GadgetReboot/Serial_UPDI/README.md

# Serial_UPDI
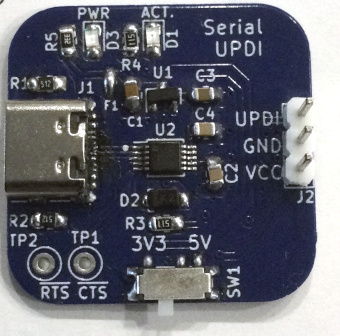
[picture p1: Assembled_PCB.jpg]
PCB
<br><br><BR><BR>
Serial UPDI Programmer
