GadgetReboot/Serial_UPDI/Sch_Serial_UPDI.pdf

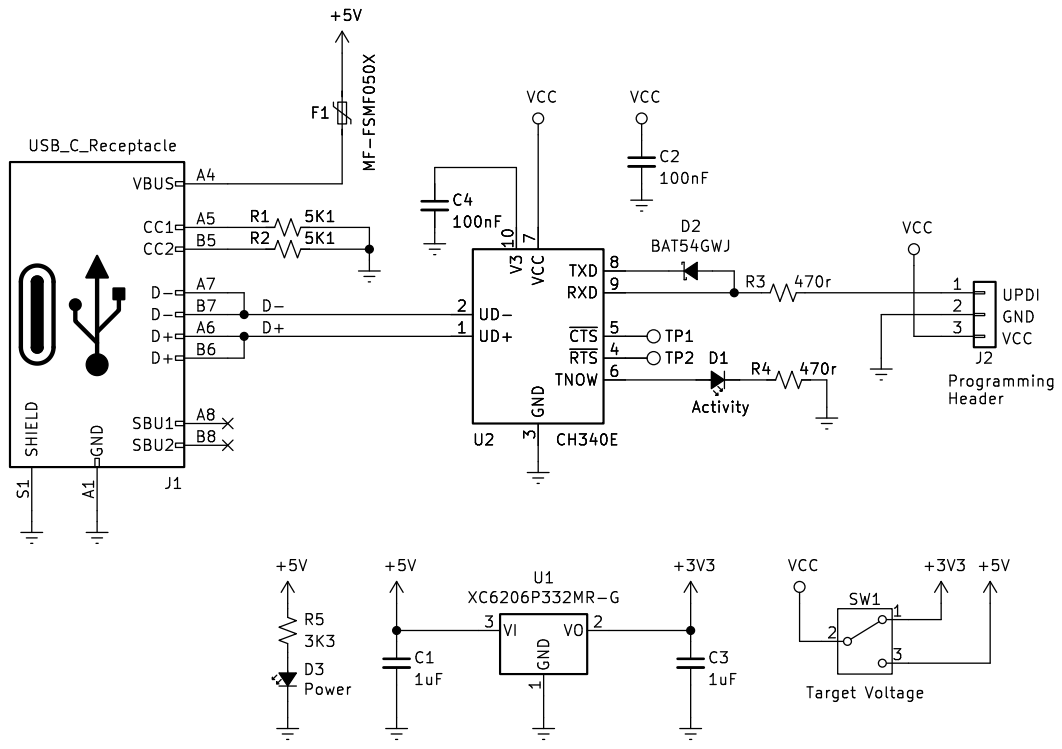
[picture p2: page 1]

7 TXD 8 RXD 9 U2 CH340E R3 470r D+D- Programming Header VCC GND

3 ~{RTS}4 ~{CTS}5 TNOW 6 VCC

https://github.com/GadgetReboot/Serial_UPDI
