GadgetReboot/Serial_UPDI/KiCad/Serial_UPDI.kicad_pcb

## KiCad design KiCad/Serial_UPDI.kicad_pcb (2024-09-14)

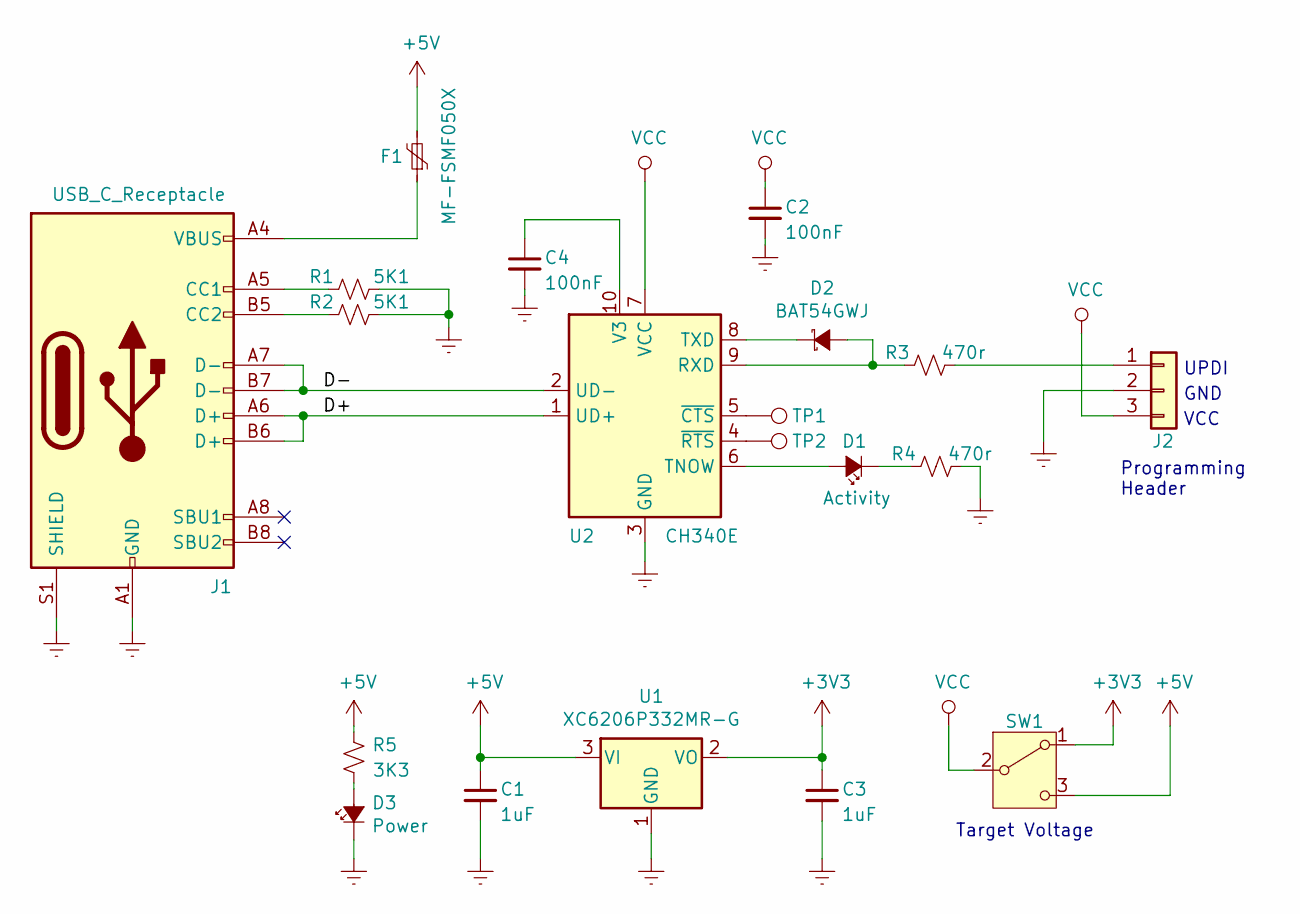
[picture p3: schematic Serial_UPDI.kicad_sch, Serial UPDI Programmer]

Parts:
C1, C3: 1uF; C_0805_2012Metric_Pad1.15x1.40mm_HandSolder
C2, C4: 100nF; C_0805_2012Metric_Pad1.15x1.40mm_HandSolder
D1: Activity; LED_0805_2012Metric_Pad1.15x1.40mm_HandSolder
D2: BAT54GWJ; SOD-123
D3: Power; LED_0805_2012Metric_Pad1.15x1.40mm_HandSolder
F1: MF-FSMF050X; R_0603_1608Metric_Pad1.05x0.95mm_HandSolder
J1: USB_C_Receptacle; USB_C_Receptacle_XKB_U262-16XN-4BVC11; Part # XKB Connectivity U262-161N-4BVC11
J2: Conn_01x03; PinHeader_1x03_P2.54mm_Vertical
R1, R2: 5K1; R_0805_2012Metric_Pad1.15x1.40mm_HandSolder
R3, R4: 470r; R_0805_2012Metric_Pad1.15x1.40mm_HandSolder
R5: 3K3; R_0805_2012Metric_Pad1.15x1.40mm_HandSolder
SW1: SW_SPDT; SW_SPDT_PCM12_
TP1, TP2: TestPoint; TestPoint_Loop_D1.80mm_Drill1.0mm_Beaded
U1: XC6206P332MR-G; SOT-23
U2: CH340E; MSOP-10_3x3mm_P0.5mm

Connections:
+3V3: C3.1, SW1.1 (A), U1.2 (VO)
+5V: C1.1, F1.2, R5.1, SW1.3 (C), U1.3 (VI)
/D+: J1.A6 (D+), J1.B6 (D+), U2.1 (UD+)
/D-: J1.A7 (D-), J1.B7 (D-), U2.2 (UD-)
GNDREF: C1.2, C2.2, C3.2, C4.2, D3.1 (K), J1.A1 (GND), J1.A12 (GND), J1.B1 (GND), J1.B12 (GND), J1.S1 (SHIELD), J2.2, R1.1, R2.1, R4.1, U1.1 (GND), U2.3 (GND)
unnamed: C4.1, U2.10 (V3)
unnamed: D1.1 (K), R4.2
unnamed: D1.2 (A), U2.6 (TNOW)
unnamed: D2.1 (K), U2.8 (TXD)
unnamed: D2.2 (A), R3.2, U2.9 (RXD)
unnamed: D3.2 (A), R5.2
unnamed: F1.1, J1.A4 (VBUS), J1.A9 (VBUS), J1.B4 (VBUS), J1.B9 (VBUS)
unnamed: J1.A5 (CC1), R1.2
unnamed: J1.B5 (CC2), R2.2
unnamed: J2.1, R3.1
unnamed: TP1.1, U2.5 (~CTS)
unnamed: TP2.1, U2.4 (~RTS)
VCC: C2.1, J2.3, SW1.2 (B), U2.7 (VCC)

Notes on the sheet:
GND
Programming Header
Target Voltage
UPDI
VCC

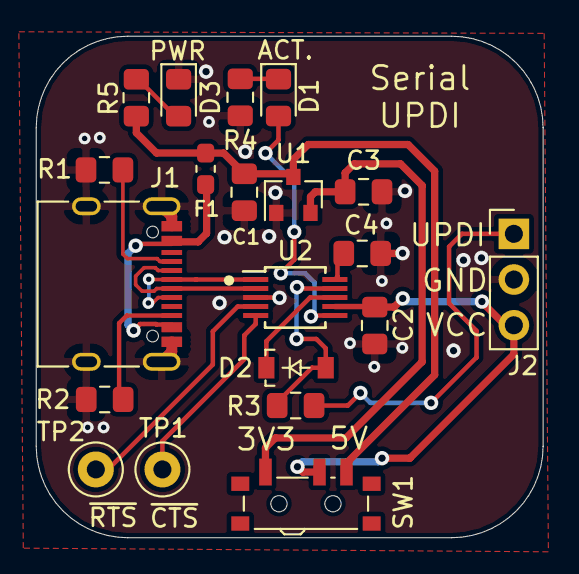
[picture p4: board Serial_UPDI.kicad_pcb from above]

Board: 2 copper layers, 28.2 x 27.9 mm, 20 parts (0 on the bottom side), 18 nets.
